izukaike/Baylor_Liquid_Propulsion_Electrical_System/README.md

# Full-Stack Rocket Engine Electronics System 🚀

This repository contains the complete embedded system and software stack used to test Baylor Aero's second liquid-fueled rocket engine. With a tight two-semester timeline and a limited budget, the system was designed from scratch to acquire real-time sensor data, control actuators, and replace costly commercial DAQ hardware with a fully custom, robust solution.

# P&ID
P&ID

# Custom Battery Module
Battery
Battery

# Sensor Data Testing

## DAC Testing
Battery
Battery

## ADC Testing
Battery
Battery
