izukaike/Baylor_Liquid_Propulsion_Electrical_System/Official Technical Document (1).pdf

## Electrical System Details

## Table of Contents

- System Details
- Hardware Details
- Software Details

## High-Level Technical Overview

High-Level Electrical System Design
- Highlights the flow of data in the system

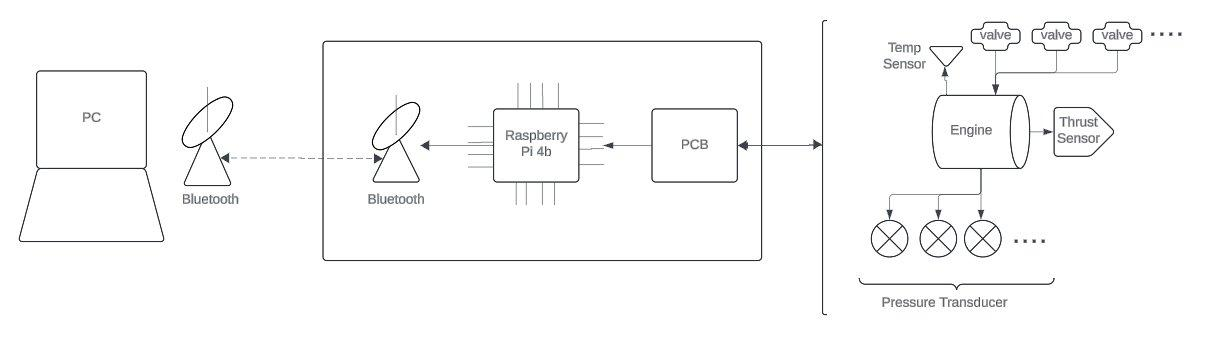
[picture p1: figure]

High-Level Block Diagram of Electrical System
- Adds more official terminology

Functional Diagram of Hardware Box
- Highlights the major hardware systems interacting with each other
- Missing are the LED’s and Sensor Filters

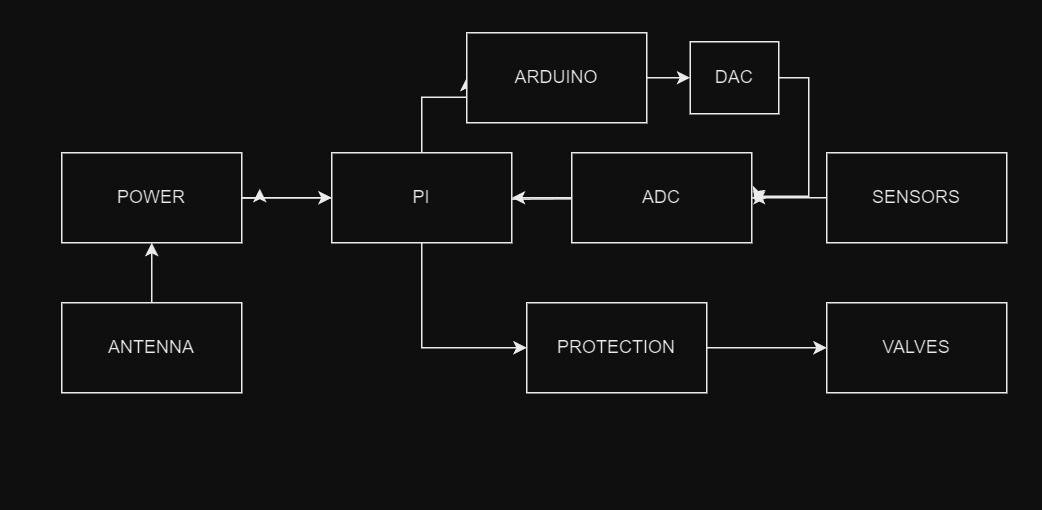
[picture p2: figure]

## Box Hardware Details

Functional Diagram
Mid-Level Function Diagram
- I do not know the testing and sensor switching for the system correct
- Missing antenna and testing/sensor switching will be updated

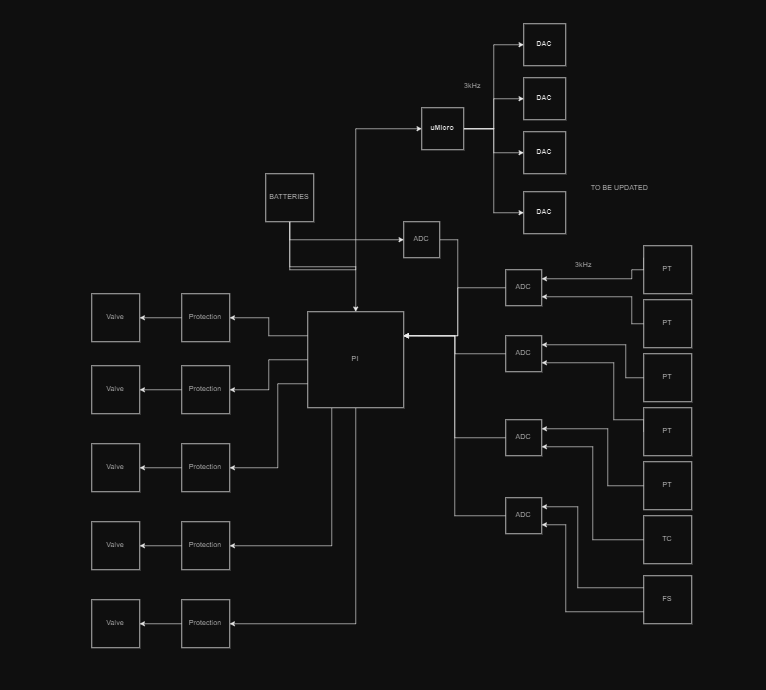
[picture p3: figure]

●

ADC 1 and 2 for Pressure Transducers
- MCP3202
- Din speed is 2x Dout Speed
- Din
- SPI
- 12-bit resolution

- SAR
- 5V
- <= 100ksps
- will use PI 5v rail as a reference voltage
- Adding diodes to sensor outputs for protection and isolation
- Will update design when available

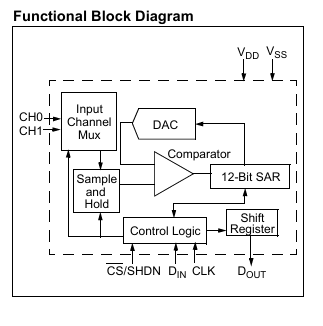
[picture p4: figure]

●

●

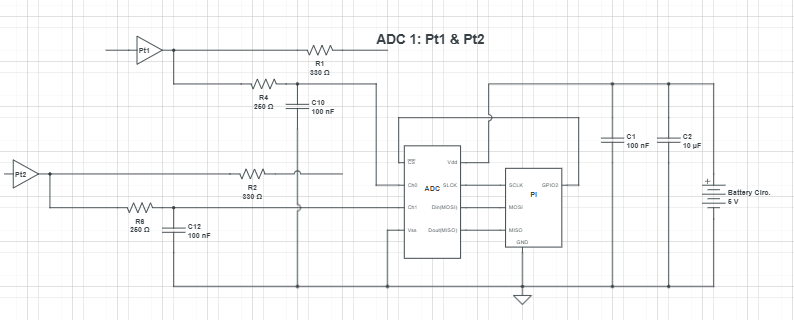
[picture p5: figure]

Force Sensor ADC

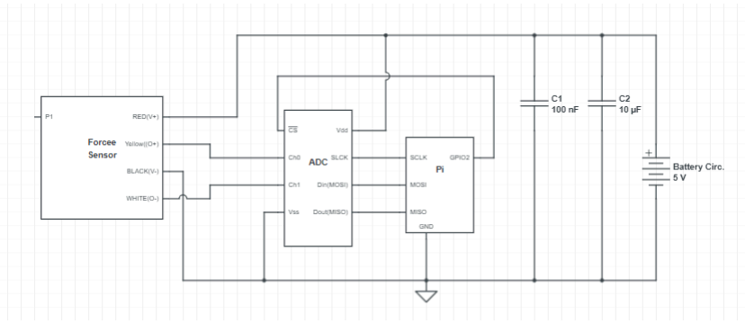
[picture p6: figure]

ThermoCouple
- Cold Junction Compensator (LT11025)
- Thermocouples work by using 0C as a reference if the system isnt at 0C we need a way to artificially show that 0V is OC and thats a CJC
- 0.5C accuracy
- 10mV/C output
- CJC

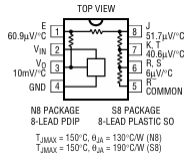
[picture p7: figure]

○

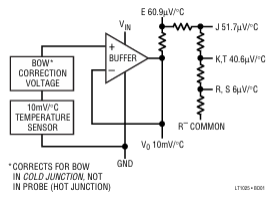
[picture p8: figure]

○

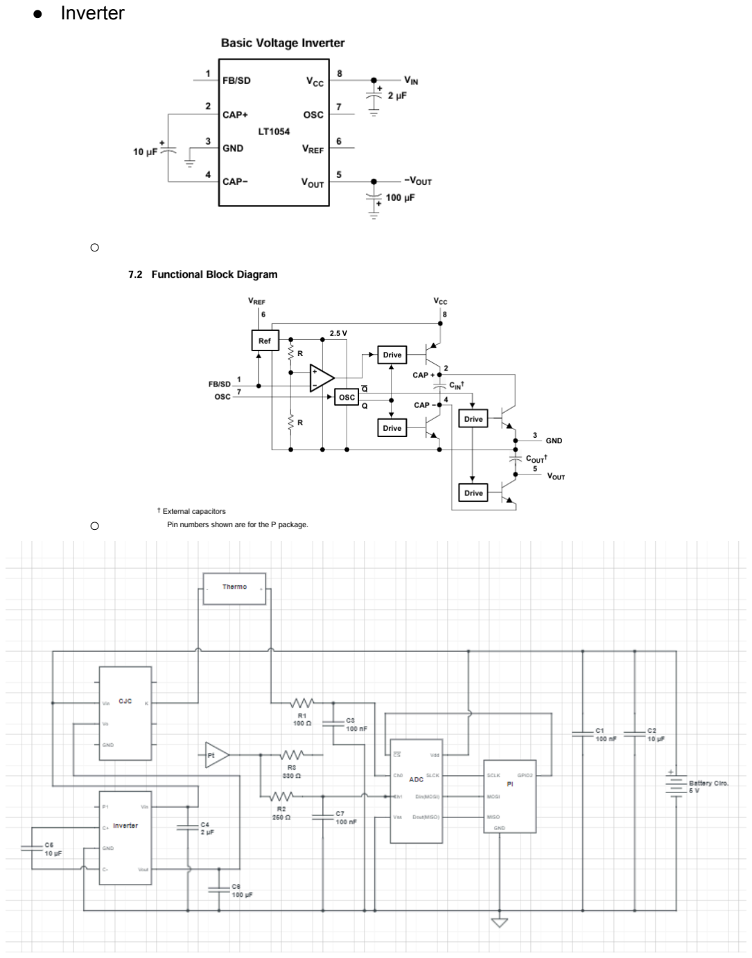
[picture p9: page 6]

- Inverter

○

○

Power System

●

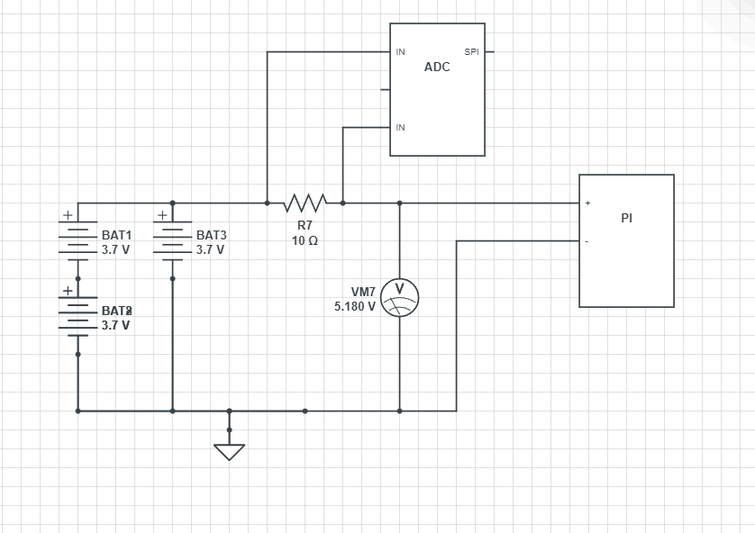
[picture p10: figure]

- Look for a way to connect pi usb-c to power jack and power jack to batteries

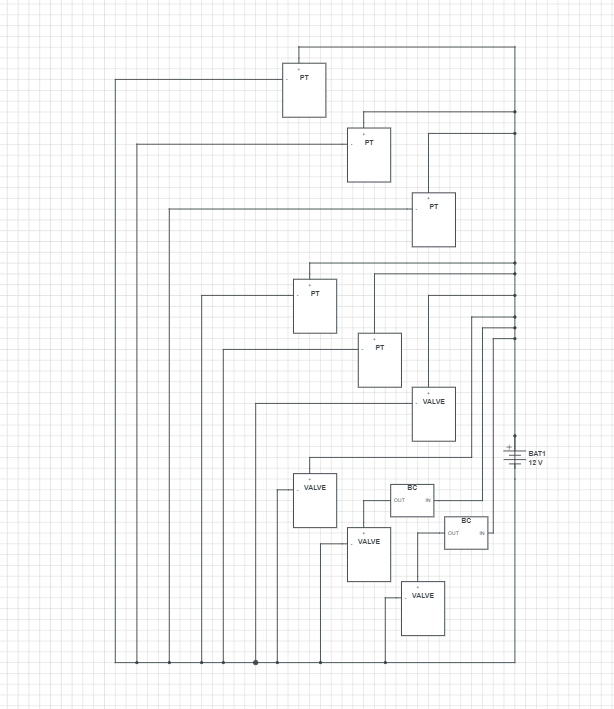
[picture p11: figure]

●

DAC For Testing
- MCP4802
- 12-bit resolution
- 3-wire SPI
- Internal Voltage Reference
- Arduino uMicro

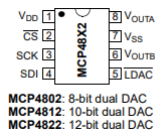
[picture p12: figure]

●

●

- Details

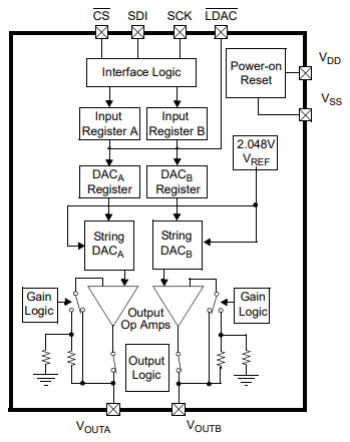
[picture p13: figure]

- Using a microcontroller to control the SPI lines of the Arduino to control the DAC hardware
- I want a async way to send data
- variable pwm to analog converter was not viable
- Arduino or esp32 does not have enough memory

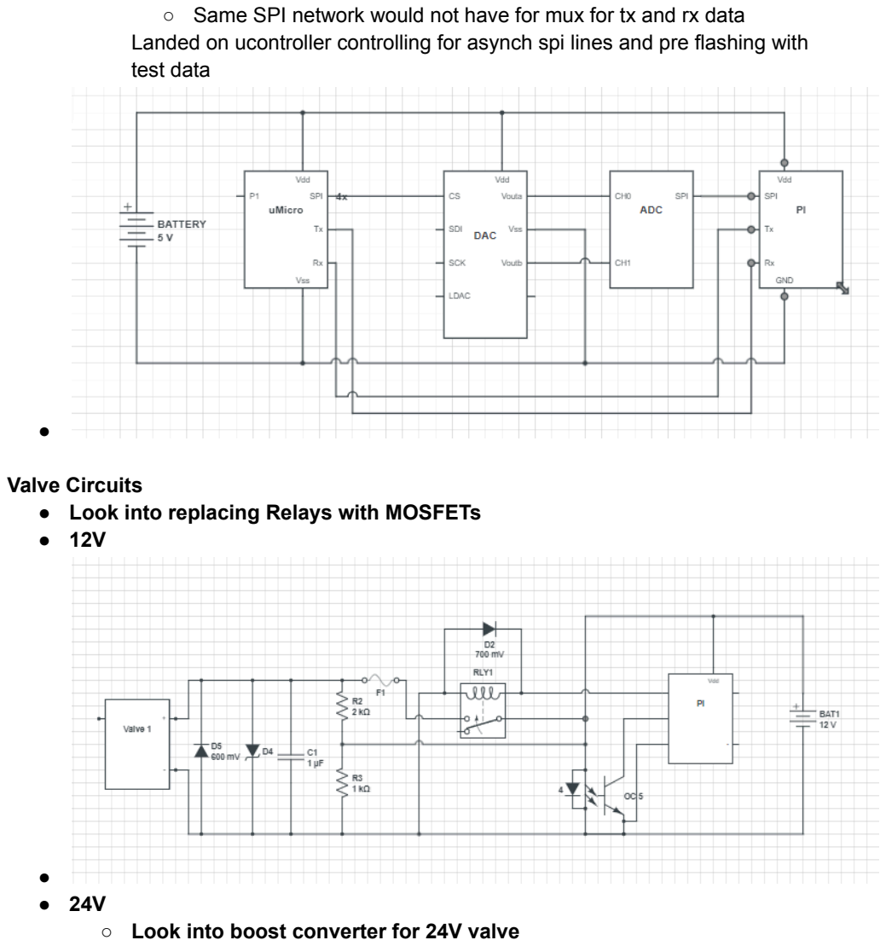
[picture p14: page 10]

- Same SPI network would not have for mux for tx and rx data Landed on ucontroller controlling for asynch spi lines and pre flashing with test data

●

Valve Circuits
- Look into replacing Relays with MOSFETs
- 12V

●
- 24V
- Look into boost converter for 24V valve

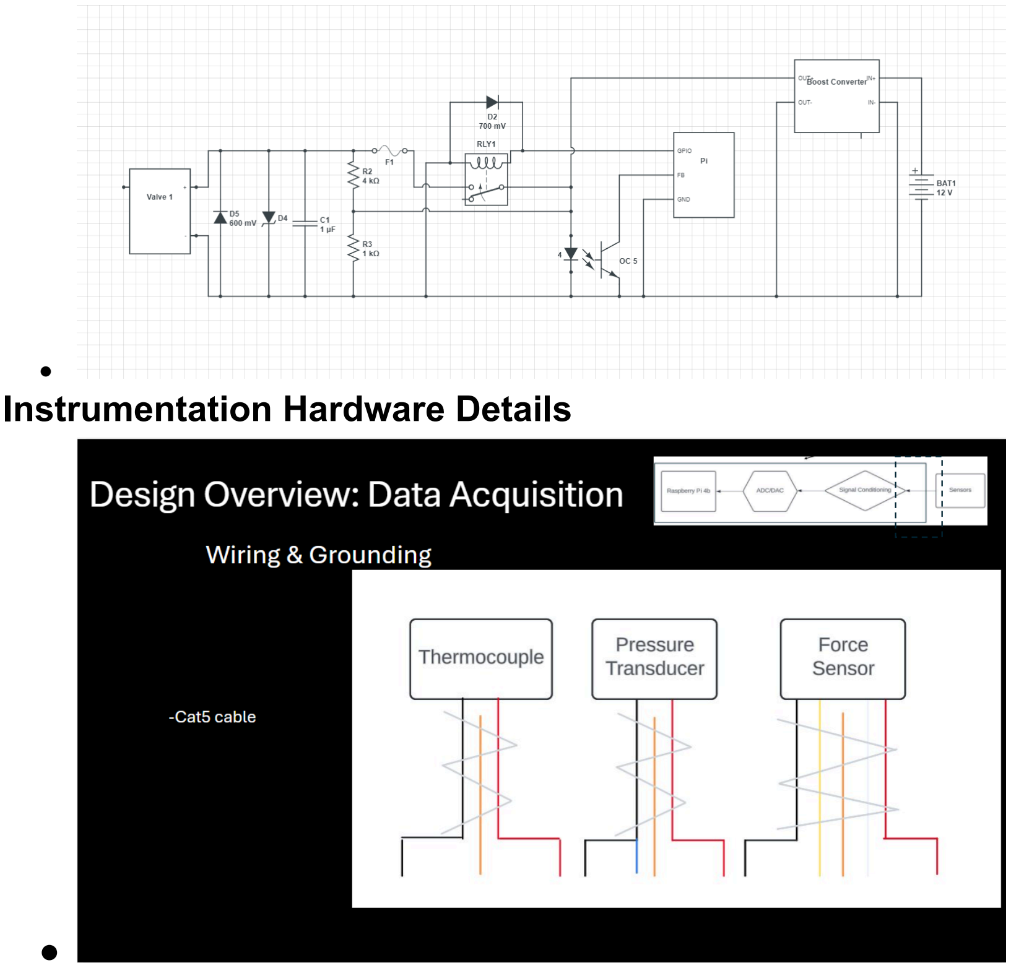
[picture p15: page 11]

●

## Instrumentation Hardware Details

●

## Software Details

- Each section is labeled a level the lower the level the lower level the software and vice versa it ranges from 0-4
- High-Level Idea of the Software System

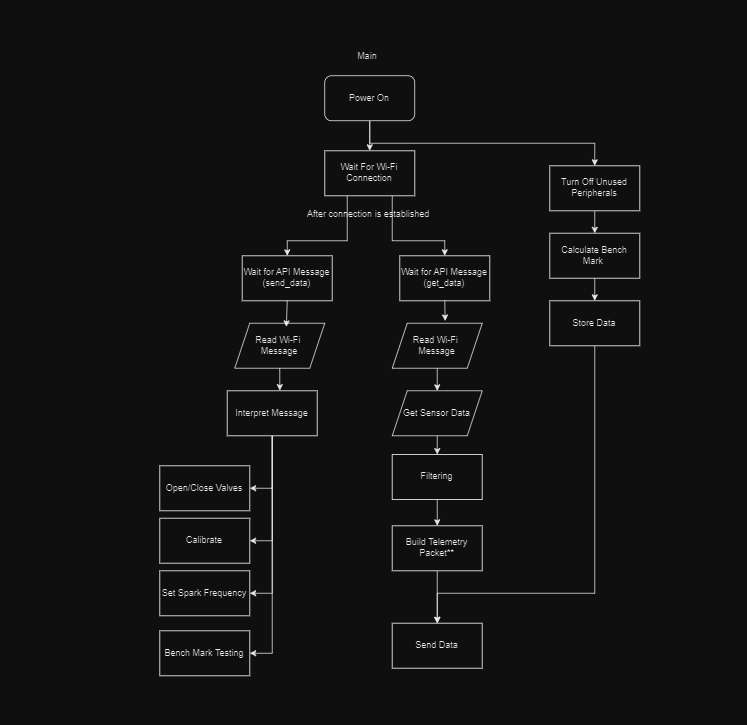
[picture p16: figure]

●

GPIO Driver
https://github.com/izukaike/V2_Electrical_System/blob/main/src/gpio.hpp Pin Hardware
- No current protection
- No overvoltage protection -> optocoupler with 3.3 volts is used
- How much current does 3.3V use?

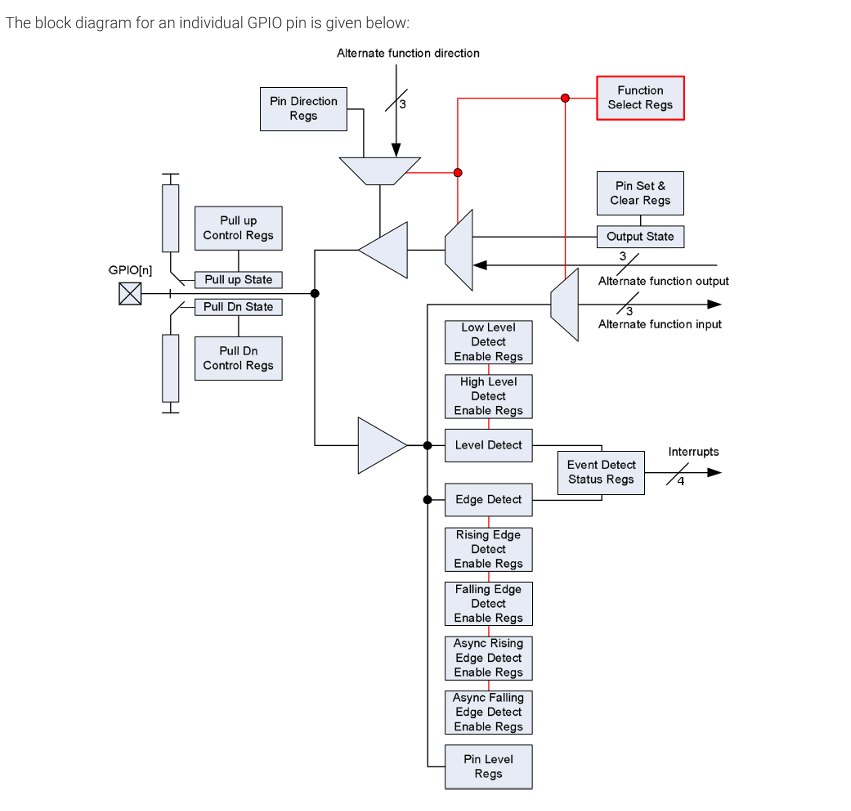
[picture p17: figure]

Client Driver
https://github.com/izukaike/V2_Electrical_System/blob/main/src/client.hpp

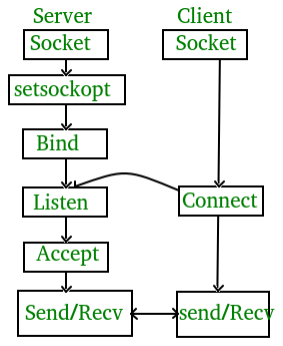
[picture p18: figure]

- Utilizes sys/socket.h -> POSIX (portable operating system interface) ->
- Connect
- Checks if sockfd is valid
- Validates rest structure -> how? idk
- Client send synch to host
- Host sends sync-ack
- Client send ack
*Notes*
- IPv4 vs IPv6
- TCP vs UDP
- IPROTO_TCP (default proto)?
- OOP Structure
- Pi Side
■ Client

■ Telemetry/WifiF
■ GPIO
■ PWM
■ ADC
■ DAC
■ Coil
■ Linux
- Py Side
■ Metrics
■ Telemetry
■ Wi-Fi Host
■ System Health

Level 1

## ADC: MCP3202

Driver: https://github.com/izukaike/V2_Electrical_System/blob/main/src/adc.cpp
- Datasheet SPI interface
- SPI Mode 0: falling clock edge, rising data edge
- 8 bits per word

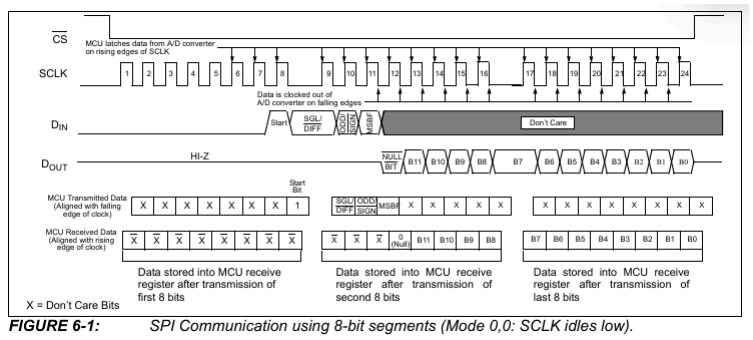
[picture p19: figure]

- My software driver
- Why Is it not working
■ use volatile?
■ Proper 5V reference voltage?
■ Read Datasheet
■ Proper Read/Write Command?
■ Arduino driver and translate to C++

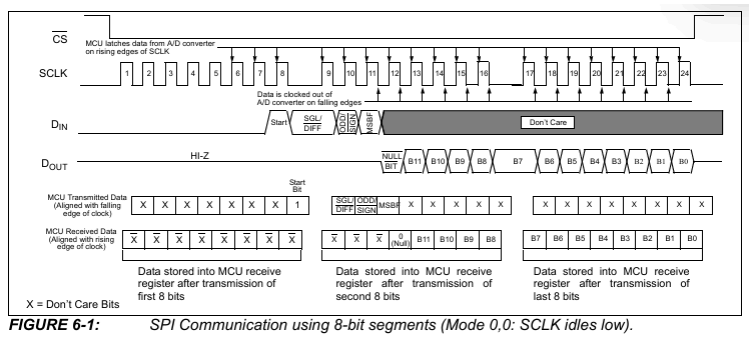
[picture p20: figure]
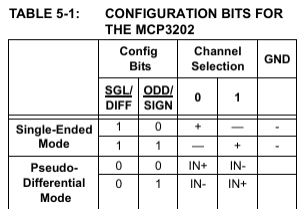
[picture p21: figure]

## DAC: MCP4822

Back-End Driver:
https://github.com/SteveGdvs/MCP48xx/blob/master/src/MCP48xx.h#L90 *look into customizing my own using my own gpio drivers too making it come full circle*

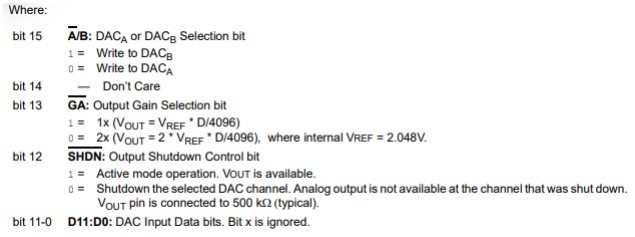
[picture p22: figure]

Bench Mark Testing
- This is the main framework I want to use to test the overall performance of the system for setting standards and general and data-driven ways to push improvements.
- I want to make a standardized way to test the system as a whole
- Things to be measured and compared
- Power draw
■ Improve power efficiency
- Wi-fi speed
■ faster ,stable,reliable wifi connection
- tx/rx speed
■ Might be synonymous with wifi
- Sensor accuracy
■ Improve signal of crucial sensor data especially with emi
- Abort Logic
■ Proper safety measures are working properly
- Memory and CPU Usage

■ Smaller mem and cpu footprint
- Temperature
■ Temperature varying performance and limits
- Security
■ how to measure security performance
- Filtering
■ How well filtering algos work

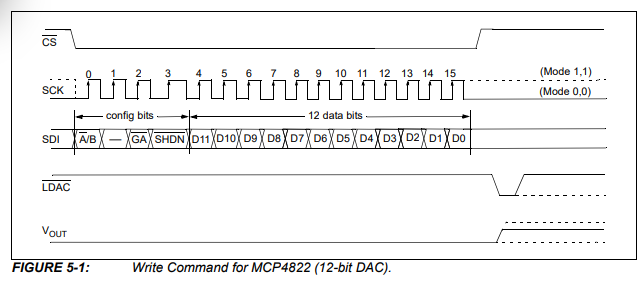
[picture p23: figure]

## power management command - parse command to get dbm and interpret what that means
