izukaike/Baylor_Liquid_Propulsion_Electrical_System/Tests/Dac_Test_Report.pdf

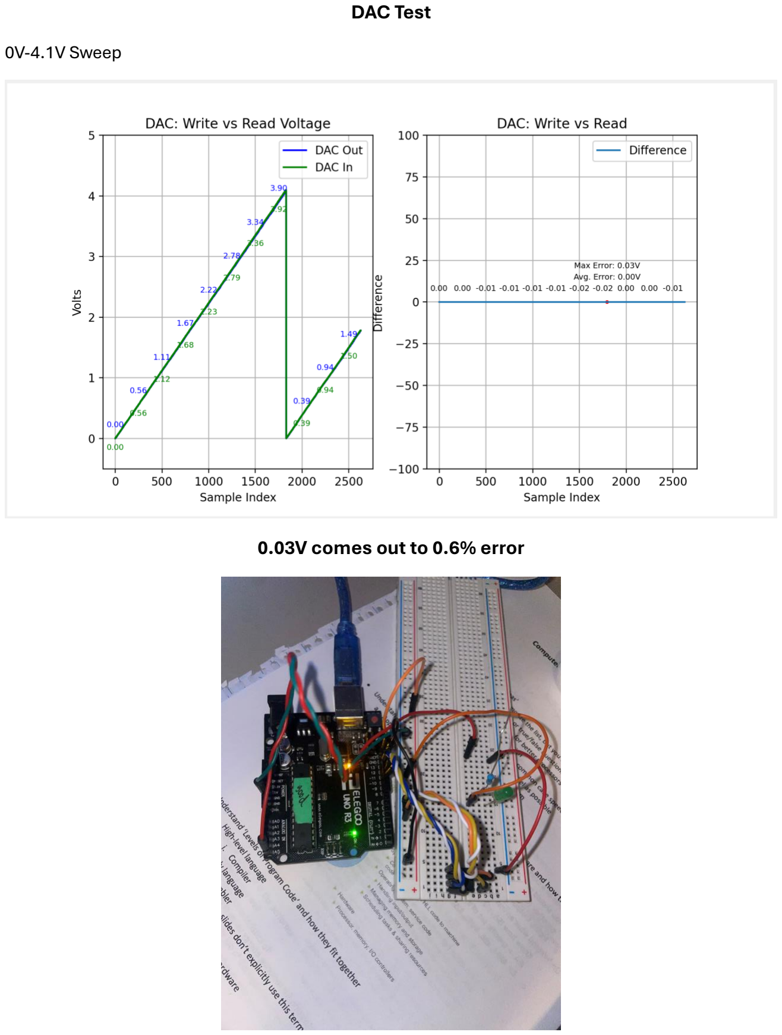
[picture p31: page 1]

DAC Test

0V-4.1V Sweep

0.03V comes out to 0.6% error
