izukaike/Baylor_Liquid_Propulsion_Electrical_System/(commit log)

2024-09-02 Add files via upload
    gpio driver from raspberry pi
2024-09-04 Add files via upload
    add adc driver
2024-09-06 Add files via upload
    preliminary dac driver -> accuracy test alreacdy passed and ready to go
